sluitz/Thermo-RTD8/kicad_pcb/Thermo-RTD8.kicad_pcb

## KiCad design kicad_pcb/Thermo-RTD8.kicad_pcb (2023-08-03)

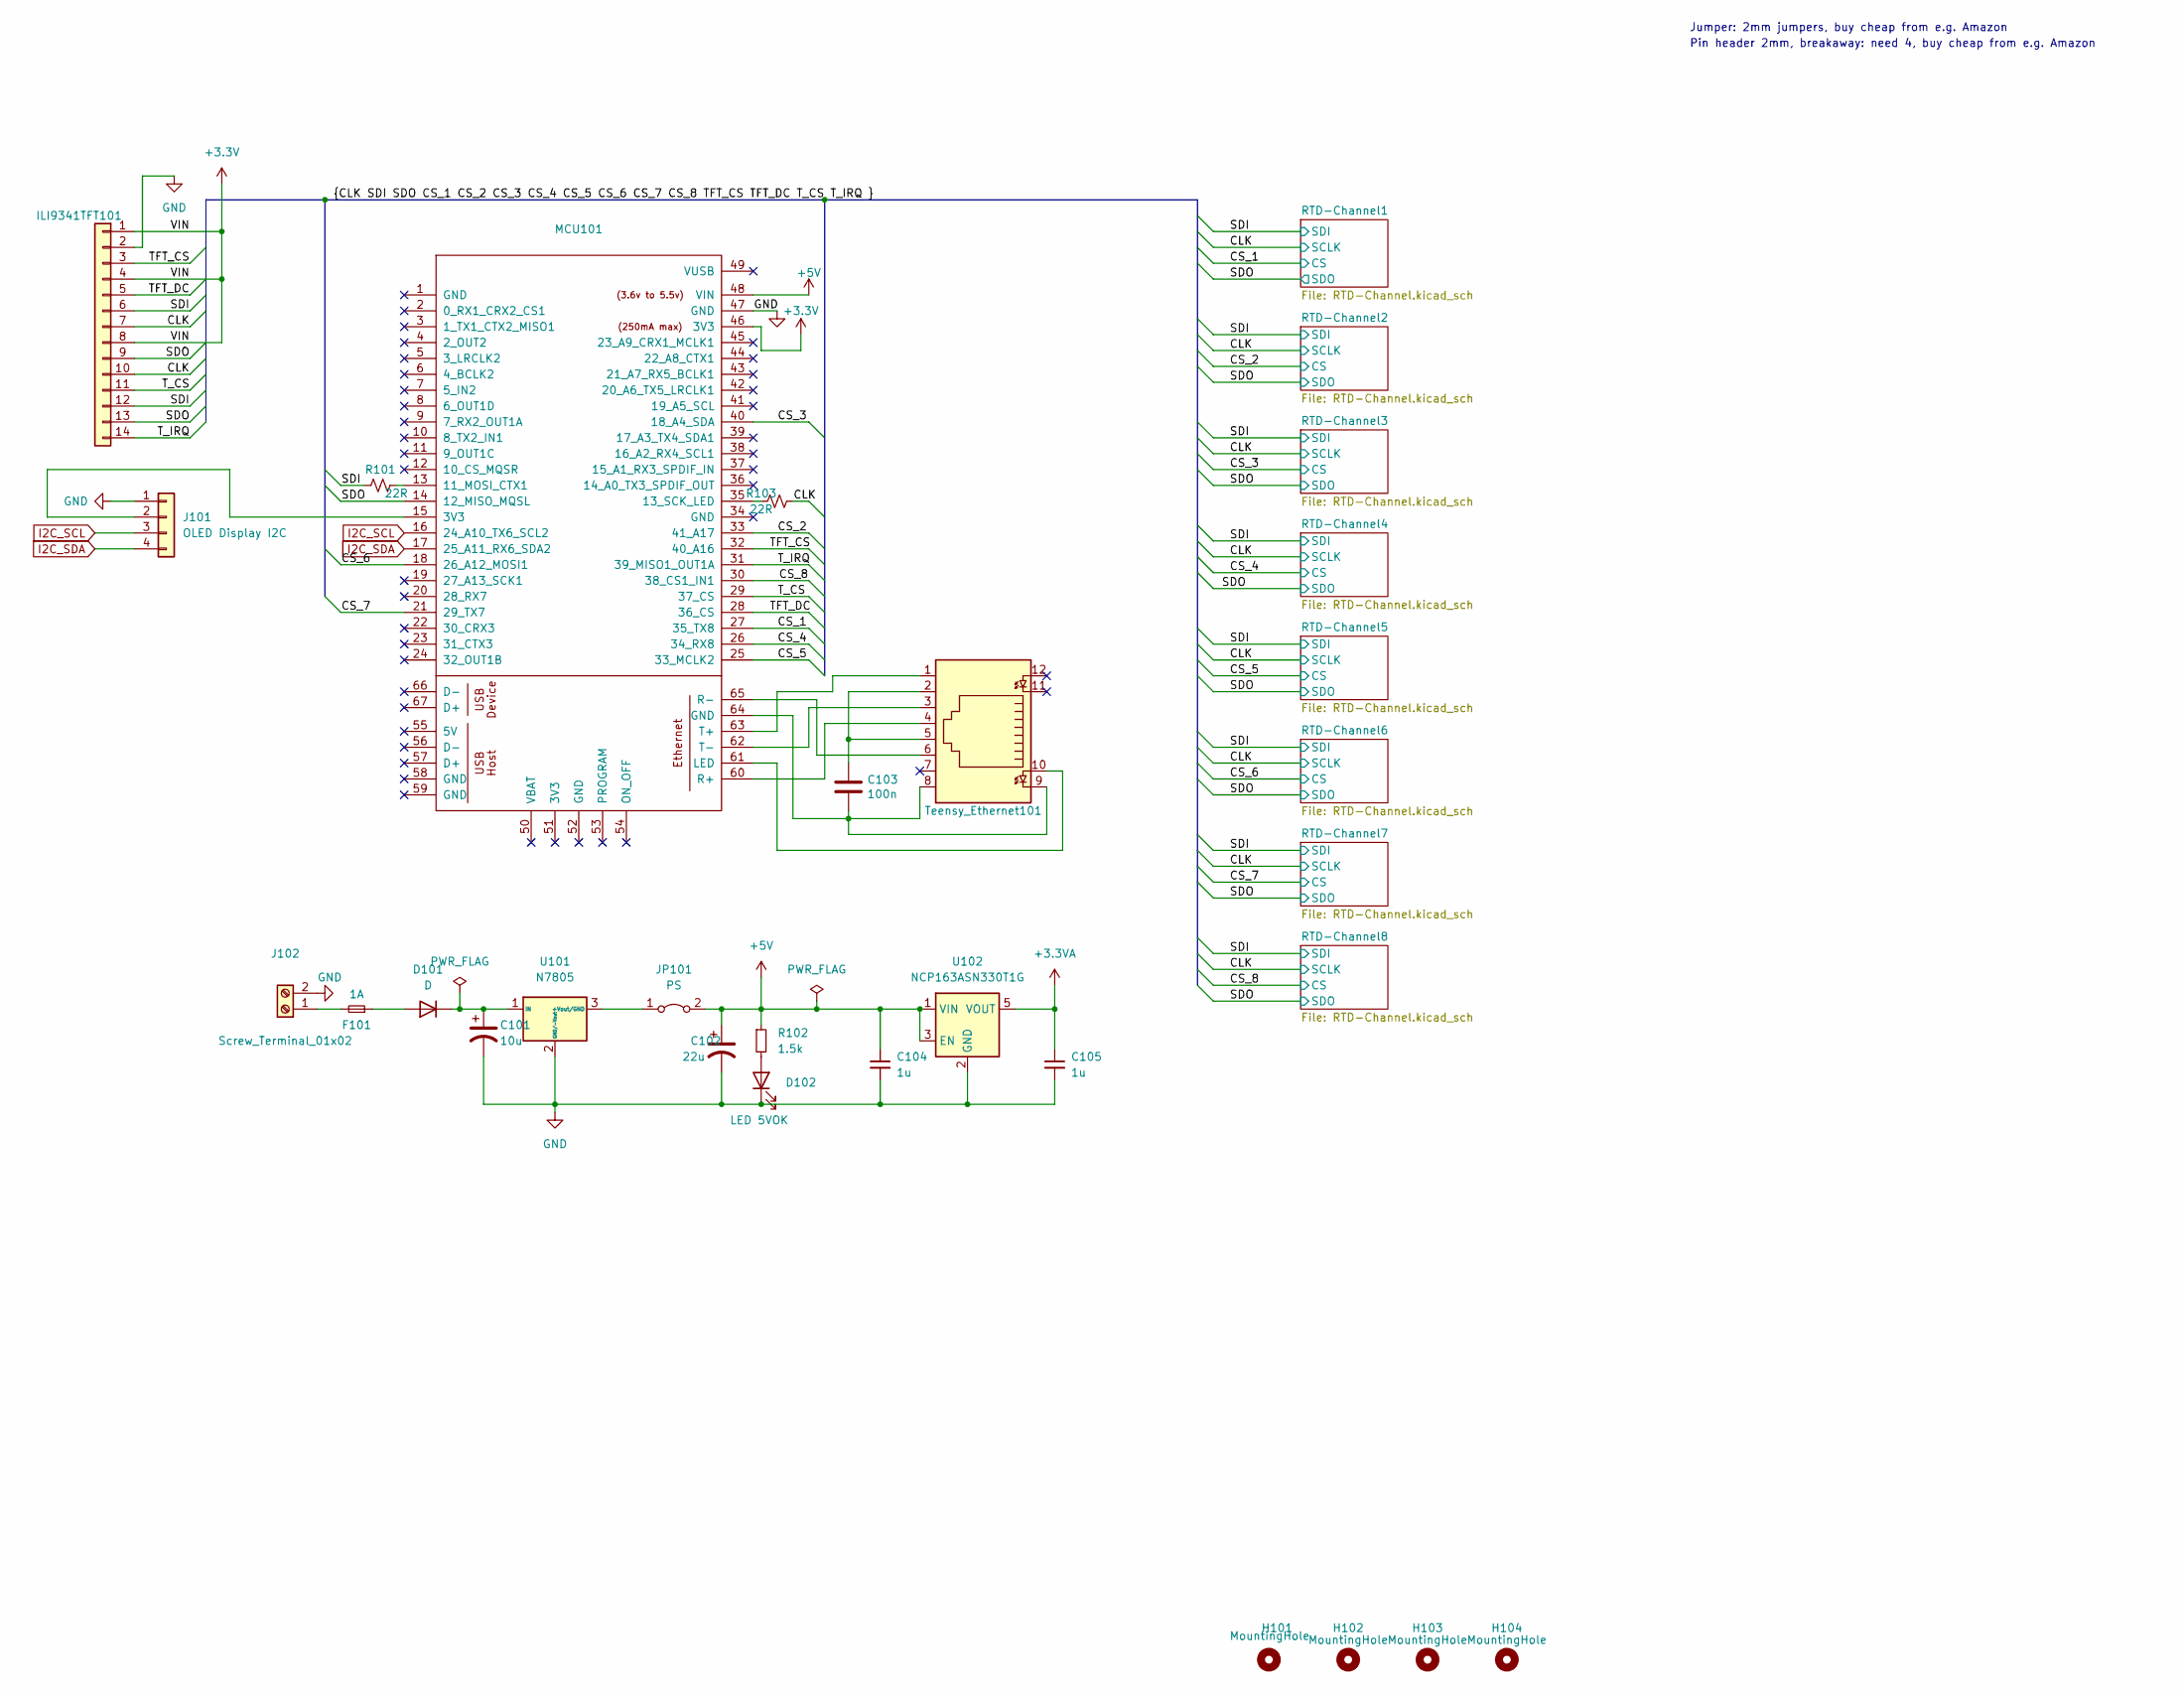
[picture p1: schematic Thermo-RTD8.kicad_sch]

Parts:
C101: 10u; CP_Radial_D5.0mm_P2.00mm
C102: 22u; CP_Radial_D5.0mm_P2.00mm
C103: 100n; C_0805_2012Metric_Pad1.18x1.45mm_HandSolder
C104, C105: 1u; C_0805_2012Metric_Pad1.18x1.45mm_HandSolder
D101: D; D_SOD-123
D102: LED 5VOK; LED_0805_2012Metric_Pad1.15x1.40mm_HandSolder
F101: 1A; smd_fuse
H101, H102, H103, H104: MountingHole; MountingHole_3.2mm_M3_DIN965
ILI9341TFT101: ILI9341TFT-RibbonCable
J101: OLED Display I2C; PinSocket_1x04_P2.54mm_Vertical
J102: Screw_Terminal_01x02; TB00750802BE
JP101: PS; PinHeader_1x02_P2.54mm_Vertical
MCU101: Teensy41
R101, R103: 22R; R_0805_2012Metric_Pad1.20x1.40mm_HandSolder
R102: 1.5k; R_0805_2012Metric_Pad1.20x1.40mm_HandSolder
Teensy_Ethernet101: RJ45_Cetus_J1B1211CCD_Horizontal
U101: N7805; N78051C
U102: NCP163ASN330T1G; SOT-23-5

Connections:
+3.3V: ILI9341TFT101.1, ILI9341TFT101.4, ILI9341TFT101.8, MCU101.46 (3V3); also elsewhere on the board
+3.3VA: C105.1, U102.5 (VOUT); also elsewhere on the board
+5V: C102.1, C104.1, JP101.2 (B), MCU101.48 (VIN), R102.1, U102.1 (VIN), U102.3 (EN)
/CLK: ILI9341TFT101.7, ILI9341TFT101.10, R103.1; also elsewhere on the board
/CS_1: MCU101.27 (35_TX8); also elsewhere on the board
/CS_2: MCU101.33 (41_A17); also elsewhere on the board
/CS_3: MCU101.40 (18_A4_SDA); also elsewhere on the board
/CS_4: MCU101.26 (34_RX8); also elsewhere on the board
/CS_5: MCU101.25 (33_MCLK2); also elsewhere on the board
/CS_6: MCU101.18 (26_A12_MOSI1); also elsewhere on the board
/CS_7: MCU101.21 (29_TX7); also elsewhere on the board
/CS_8: MCU101.30 (38_CS1_IN1); also elsewhere on the board
/SDI: ILI9341TFT101.6, ILI9341TFT101.12, R101.2; also elsewhere on the board
/SDO: ILI9341TFT101.9, ILI9341TFT101.13, MCU101.14 (12_MISO_MQSL); also elsewhere on the board
/TFT_CS: ILI9341TFT101.3, MCU101.32 (40_A16)
/TFT_DC: ILI9341TFT101.5, MCU101.28 (36_CS)
/T_CS: ILI9341TFT101.11, MCU101.29 (37_CS)
/T_IRQ: ILI9341TFT101.14, MCU101.31 (39_MISO1_OUT1A)
GND: C101.2, C102.2, C104.2, C105.2, D102.1 (K), ILI9341TFT101.2, J101.1, J102.2, MCU101.47 (GND), U101.2 (GND/-Vout), U102.2 (GND); also elsewhere on the board
I2C_SCL: J101.3, MCU101.16 (24_A10_TX6_SCL2)
I2C_SDA: J101.4, MCU101.17 (25_A11_RX6_SDA2)
unnamed: C103.1, Teensy_Ethernet101.2, Teensy_Ethernet101.5
unnamed: C103.2, MCU101.64 (GND), Teensy_Ethernet101.8, Teensy_Ethernet101.9
unnamed: D101.2 (A), F101.1
unnamed: C101.1, D101.1 (K), U101.1 (IN)
unnamed: D102.2 (A), R102.2
unnamed: J101.2, MCU101.15 (3V3)
unnamed: F101.2, J102.1
unnamed: JP101.1 (A), U101.3 (+Vout/GND)
unnamed: MCU101.13 (11_MOSI_CTX1), R101.1
unnamed: MCU101.35 (13_SCK_LED), R103.2
unnamed: MCU101.61 (LED), Teensy_Ethernet101.10
unnamed: MCU101.60 (R+), Teensy_Ethernet101.4
unnamed: MCU101.65 (R-), Teensy_Ethernet101.6
unnamed: MCU101.63 (T+), Teensy_Ethernet101.1
unnamed: MCU101.62 (T-), Teensy_Ethernet101.3

Notes on the sheet:
Pin header 2mm, breakaway: need 4, buy cheap from e.g. Amazon
Jumper: 2mm jumpers, buy cheap from e.g. Amazon

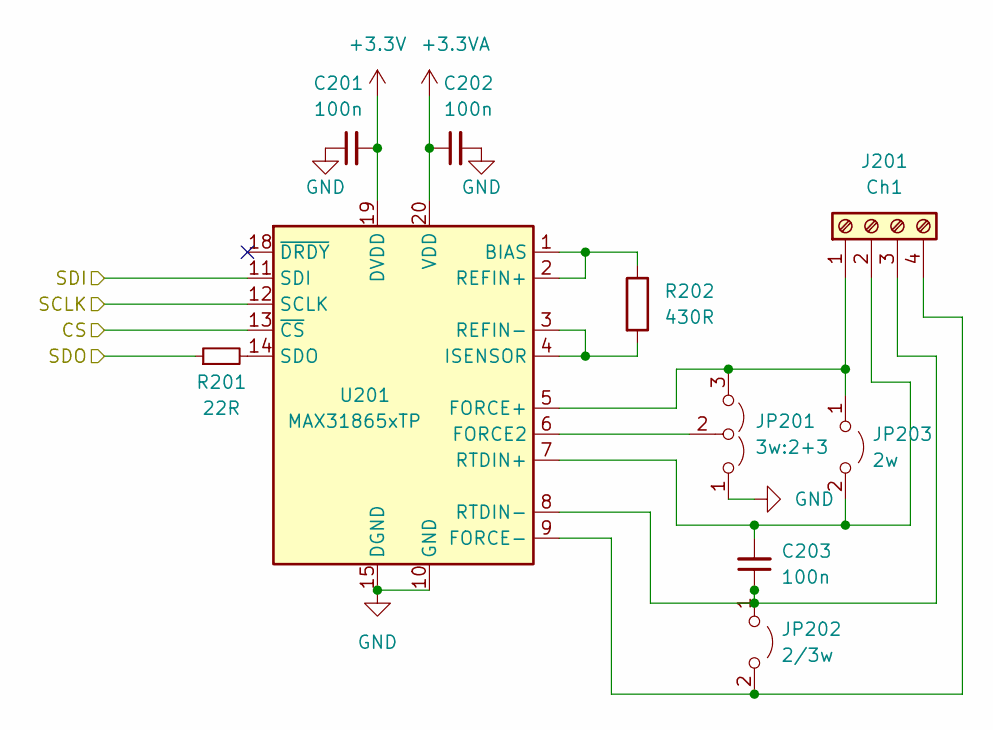
[picture p2: schematic RTD-Channel.kicad_sch]

Parts:
C201, C202, C203: 100n; C_0805_2012Metric_Pad1.18x1.45mm_HandSolder
J201: Ch1; TerminalBlock_Phoenix_PT-1,5-4-3.5-H_1x04_P3.50mm_Horizontal
JP201: 3w:2+3; PinHeader_1x03_P2.00mm_Vertical
JP202: 2/3w; PinHeader_1x02_P2.00mm_Vertical
JP203: 2w; PinHeader_1x02_P2.00mm_Vertical
R201: 22R; R_0805_2012Metric_Pad1.20x1.40mm_HandSolder
R202: 430R; R_0805_2012Metric_Pad1.20x1.40mm_HandSolder
U201: MAX31865xTP; TQFN-20-1EP_5x5mm_P0.65mm_EP3.25x3.25mm

Connections:
+3.3V: C201.2, U201.19 (DVDD); also elsewhere on the board
+3.3VA: C202.1, U201.20 (VDD); also elsewhere on the board
/CLK: U201.12 (SCLK); also elsewhere on the board
/CS_1: U201.13 (~CS); also elsewhere on the board
/SDI: U201.11 (SDI); also elsewhere on the board
/SDO: R201.1; also elsewhere on the board
GND: C201.1, C202.2, JP201.1 (A), U201.10 (GND), U201.15 (DGND), U201.16 (GND), U201.21 (GND); also elsewhere on the board
unnamed: J201.1, JP201.3 (B), JP203.1 (A), U201.5 (FORCE+)
unnamed: C203.2, J201.2, JP203.2 (B), U201.7 (RTDIN+)
unnamed: C203.1, J201.3, JP202.1 (A), U201.8 (RTDIN-)
unnamed: J201.4, JP202.2 (B), U201.9 (FORCE-)
unnamed: JP201.2 (C), U201.6 (FORCE2)
unnamed: R202.1, U201.1 (BIAS), U201.2 (REFIN+)
unnamed: R202.2, U201.3 (REFIN-), U201.4 (ISENSOR)
unnamed: R201.2, U201.14 (SDO)

Parts of its further copies:
C301, C302, C303, C401, C402, C403, C501, C502, C503, C601, C602, C603, C701, C702, C703, C801, C802, C803, C901, C902, C903: 100n; C_0805_2012Metric_Pad1.18x1.45mm_HandSolder
J301, J401, J501, J601, J701, J801, J901: Ch1; TerminalBlock_Phoenix_PT-1,5-4-3.5-H_1x04_P3.50mm_Horizontal
JP301, JP401, JP501, JP601, JP701, JP801, JP901: 3w:2+3; PinHeader_1x03_P2.00mm_Vertical
JP302, JP402, JP502, JP602, JP702, JP802, JP902: 2/3w; PinHeader_1x02_P2.00mm_Vertical
JP303, JP403, JP503, JP603, JP703, JP803, JP903: 2w; PinHeader_1x02_P2.00mm_Vertical
R301, R401, R501, R601, R701, R801, R901: 22R; R_0805_2012Metric_Pad1.20x1.40mm_HandSolder
U301, U401, U501, U601, U701, U801, U901: MAX31865xTP; TQFN-20-1EP_5x5mm_P0.65mm_EP3.25x3.25mm

Connections of its further copies:
+3.3V: C301.2, C401.2, C501.2, C601.2, C701.2, C801.2, C901.2, U301.19 (DVDD), U401.19 (DVDD), U501.19 (DVDD), U601.19 (DVDD), U701.19 (DVDD), U801.19 (DVDD), U901.19 (DVDD); also elsewhere on the board
+3.3VA: C302.1, C402.1, C502.1, C602.1, C702.1, C802.1, C902.1, U301.20 (VDD), U401.20 (VDD), U501.20 (VDD), U601.20 (VDD), U701.20 (VDD), U801.20 (VDD), U901.20 (VDD); also elsewhere on the board
/CLK: U301.12 (SCLK), U401.12 (SCLK), U501.12 (SCLK), U601.12 (SCLK), U701.12 (SCLK), U801.12 (SCLK), U901.12 (SCLK); also elsewhere on the board
/CS_2: U401.13 (~CS); also elsewhere on the board
/CS_3: U301.13 (~CS); also elsewhere on the board
/CS_4: U501.13 (~CS); also elsewhere on the board
/CS_5: U601.13 (~CS); also elsewhere on the board
/CS_6: U701.13 (~CS); also elsewhere on the board
/CS_7: U801.13 (~CS); also elsewhere on the board
/CS_8: U901.13 (~CS); also elsewhere on the board
/SDI: U301.11 (SDI), U401.11 (SDI), U501.11 (SDI), U601.11 (SDI), U701.11 (SDI), U801.11 (SDI), U901.11 (SDI); also elsewhere on the board
/SDO: R301.1, R401.1, R501.1, R601.1, R701.1, R801.1, R901.1; also elsewhere on the board
GND: C301.1, C302.2, C401.1, C402.2, C501.1, C502.2, C601.1, C602.2, C701.1, C702.2, C801.1, C802.2, C901.1, C902.2, JP301.1 (A), JP401.1 (A), JP501.1 (A), JP601.1 (A), JP701.1 (A), JP801.1 (A), JP901.1 (A), U301.10 (GND), U301.15 (DGND), U301.16 (GND), U301.21 (GND), U401.10 (GND), U401.15 (DGND), U401.16 (GND), U401.21 (GND), U501.10 (GND), U501.15 (DGND), U501.16 (GND), U501.21 (GND), U601.10 (GND), U601.15 (DGND), U601.16 (GND), U601.21 (GND), U701.10 (GND), U701.15 (DGND), U701.16 (GND), U701.21 (GND), U801.10 (GND), U801.15 (DGND), U801.16 (GND), U801.21 (GND), U901.10 (GND), U901.15 (DGND), U901.16 (GND), U901.21 (GND); also elsewhere on the board
unnamed: J301.1, JP301.3 (B), JP303.1 (A), U301.5 (FORCE+)
unnamed: C303.2, J301.2, JP303.2 (B), U301.7 (RTDIN+)
unnamed: C303.1, J301.3, JP302.1 (A), U301.8 (RTDIN-)
unnamed: J301.4, JP302.2 (B), U301.9 (FORCE-)
unnamed: J401.1, JP401.3 (B), JP403.1 (A), U401.5 (FORCE+)
unnamed: C403.2, J401.2, JP403.2 (B), U401.7 (RTDIN+)
unnamed: C403.1, J401.3, JP402.1 (A), U401.8 (RTDIN-)
unnamed: J401.4, JP402.2 (B), U401.9 (FORCE-)
unnamed: J501.1, JP501.3 (B), JP503.1 (A), U501.5 (FORCE+)
unnamed: C503.2, J501.2, JP503.2 (B), U501.7 (RTDIN+)
unnamed: C503.1, J501.3, JP502.1 (A), U501.8 (RTDIN-)
unnamed: J501.4, JP502.2 (B), U501.9 (FORCE-)
unnamed: J601.1, JP601.3 (B), JP603.1 (A), U601.5 (FORCE+)
unnamed: C603.2, J601.2, JP603.2 (B), U601.7 (RTDIN+)
unnamed: C603.1, J601.3, JP602.1 (A), U601.8 (RTDIN-)
unnamed: J601.4, JP602.2 (B), U601.9 (FORCE-)
unnamed: J701.1, JP701.3 (B), JP703.1 (A), U701.5 (FORCE+)
unnamed: C703.2, J701.2, JP703.2 (B), U701.7 (RTDIN+)
unnamed: C703.1, J701.3, JP702.1 (A), U701.8 (RTDIN-)
unnamed: J701.4, JP702.2 (B), U701.9 (FORCE-)
unnamed: J801.1, JP801.3 (B), JP803.1 (A), U801.5 (FORCE+)
unnamed: C803.2, J801.2, JP803.2 (B), U801.7 (RTDIN+)
unnamed: C803.1, J801.3, JP802.1 (A), U801.8 (RTDIN-)
unnamed: J801.4, JP802.2 (B), U801.9 (FORCE-)
unnamed: J901.1, JP901.3 (B), JP903.1 (A), U901.5 (FORCE+)
unnamed: C903.2, J901.2, JP903.2 (B), U901.7 (RTDIN+)
unnamed: C903.1, J901.3, JP902.1 (A), U901.8 (RTDIN-)
unnamed: J901.4, JP902.2 (B), U901.9 (FORCE-)
unnamed: JP301.2 (C), U301.6 (FORCE2)
unnamed: JP401.2 (C), U401.6 (FORCE2)
unnamed: JP501.2 (C), U501.6 (FORCE2)
unnamed: JP601.2 (C), U601.6 (FORCE2)
unnamed: JP701.2 (C), U701.6 (FORCE2)
unnamed: JP801.2 (C), U801.6 (FORCE2)
unnamed: JP901.2 (C), U901.6 (FORCE2)
unnamed 79: U301.1 (BIAS), U301.2 (REFIN+); also elsewhere on the board
unnamed 80: U301.3 (REFIN-), U301.4 (ISENSOR); also elsewhere on the board
unnamed: R301.2, U301.14 (SDO)
unnamed 82: U401.1 (BIAS), U401.2 (REFIN+); also elsewhere on the board
unnamed 83: U401.3 (REFIN-), U401.4 (ISENSOR); also elsewhere on the board
unnamed: R401.2, U401.14 (SDO)
unnamed 85: U501.1 (BIAS), U501.2 (REFIN+); also elsewhere on the board
unnamed 86: U501.3 (REFIN-), U501.4 (ISENSOR); also elsewhere on the board
unnamed: R501.2, U501.14 (SDO)
unnamed 88: U601.1 (BIAS), U601.2 (REFIN+); also elsewhere on the board
unnamed 89: U601.3 (REFIN-), U601.4 (ISENSOR); also elsewhere on the board
unnamed: R601.2, U601.14 (SDO)
unnamed 91: U701.1 (BIAS), U701.2 (REFIN+); also elsewhere on the board
unnamed 92: U701.3 (REFIN-), U701.4 (ISENSOR); also elsewhere on the board
unnamed: R701.2, U701.14 (SDO)
unnamed 94: U801.1 (BIAS), U801.2 (REFIN+); also elsewhere on the board
unnamed 95: U801.3 (REFIN-), U801.4 (ISENSOR); also elsewhere on the board
unnamed: R801.2, U801.14 (SDO)
unnamed 97: U901.1 (BIAS), U901.2 (REFIN+); also elsewhere on the board
unnamed 98: U901.3 (REFIN-), U901.4 (ISENSOR); also elsewhere on the board
unnamed: R901.2, U901.14 (SDO)

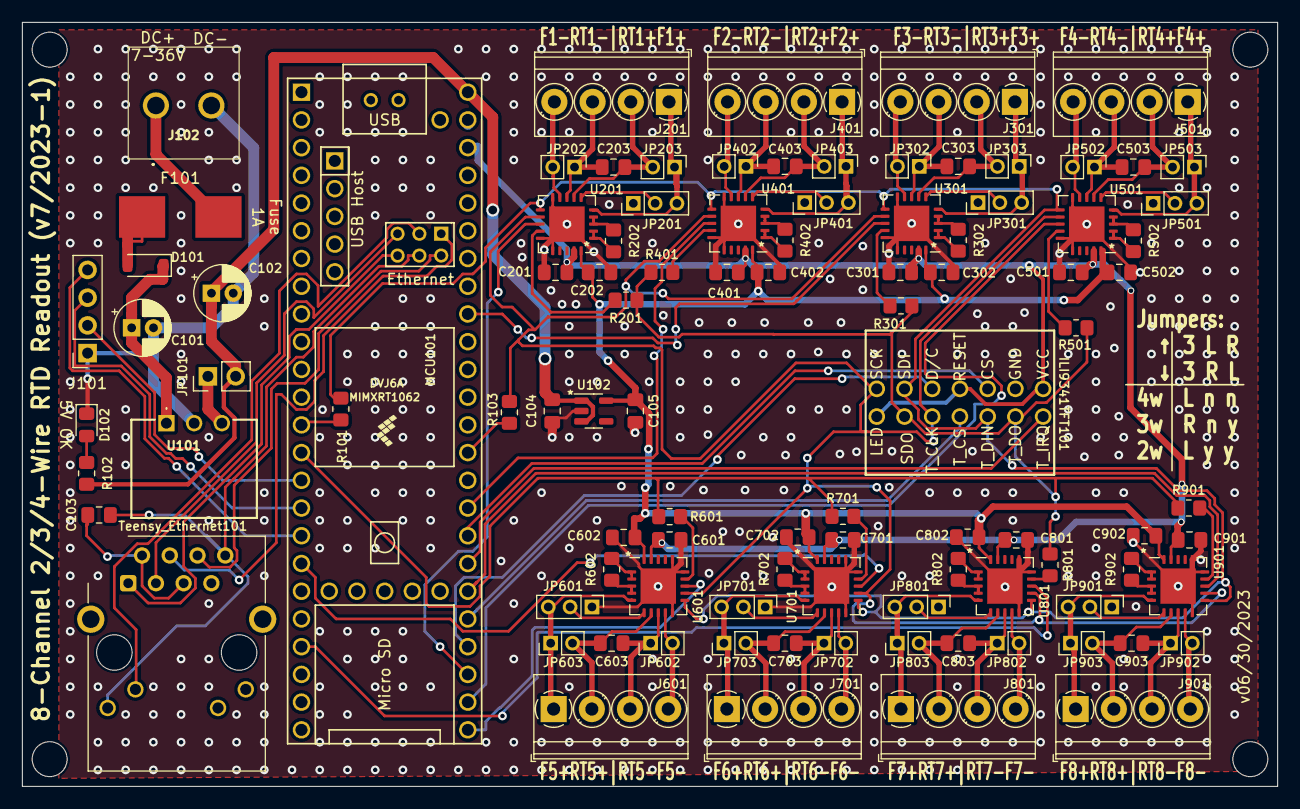
[picture p3: board Thermo-RTD8.kicad_pcb from above]

Board: 2 copper layers, 115.0 x 70.0 mm, 103 parts (0 on the bottom side), 100 nets.

Other parts of the board:
R302, R402, R502, R602, R702, R802, R902: 440R; R_0805_2012Metric_Pad1.20x1.40mm_HandSolder

Their connections:
unnamed 79: R302.1; also elsewhere on the board
unnamed 80: R302.2; also elsewhere on the board
unnamed 82: R402.1; also elsewhere on the board
unnamed 83: R402.2; also elsewhere on the board
unnamed 85: R502.1; also elsewhere on the board
unnamed 86: R502.2; also elsewhere on the board
unnamed 88: R602.1; also elsewhere on the board
unnamed 89: R602.2; also elsewhere on the board
unnamed 91: R702.1; also elsewhere on the board
unnamed 92: R702.2; also elsewhere on the board
unnamed 94: R802.1; also elsewhere on the board
unnamed 95: R802.2; also elsewhere on the board
unnamed 97: R902.1; also elsewhere on the board
unnamed 98: R902.2; also elsewhere on the board
